FragHunter/DuePointVentilation/cad/heat-exchanger/review/HX-V1.1/05_room_end_plate_XY.png

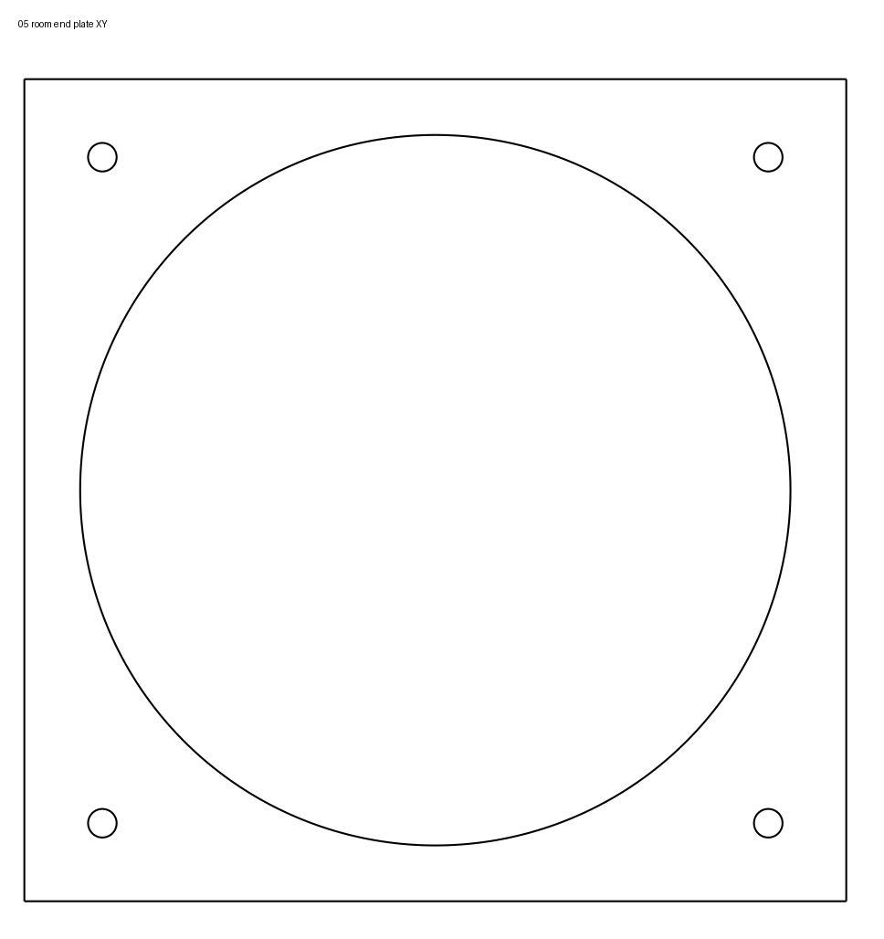
cad/heat-exchanger/review/HX-V1.1/05_room_end_plate_XY.png
