FragHunter/DuePointVentilation/cad/heat-exchanger/simulation/HX-V1.1/pressure-drop-sweep.png

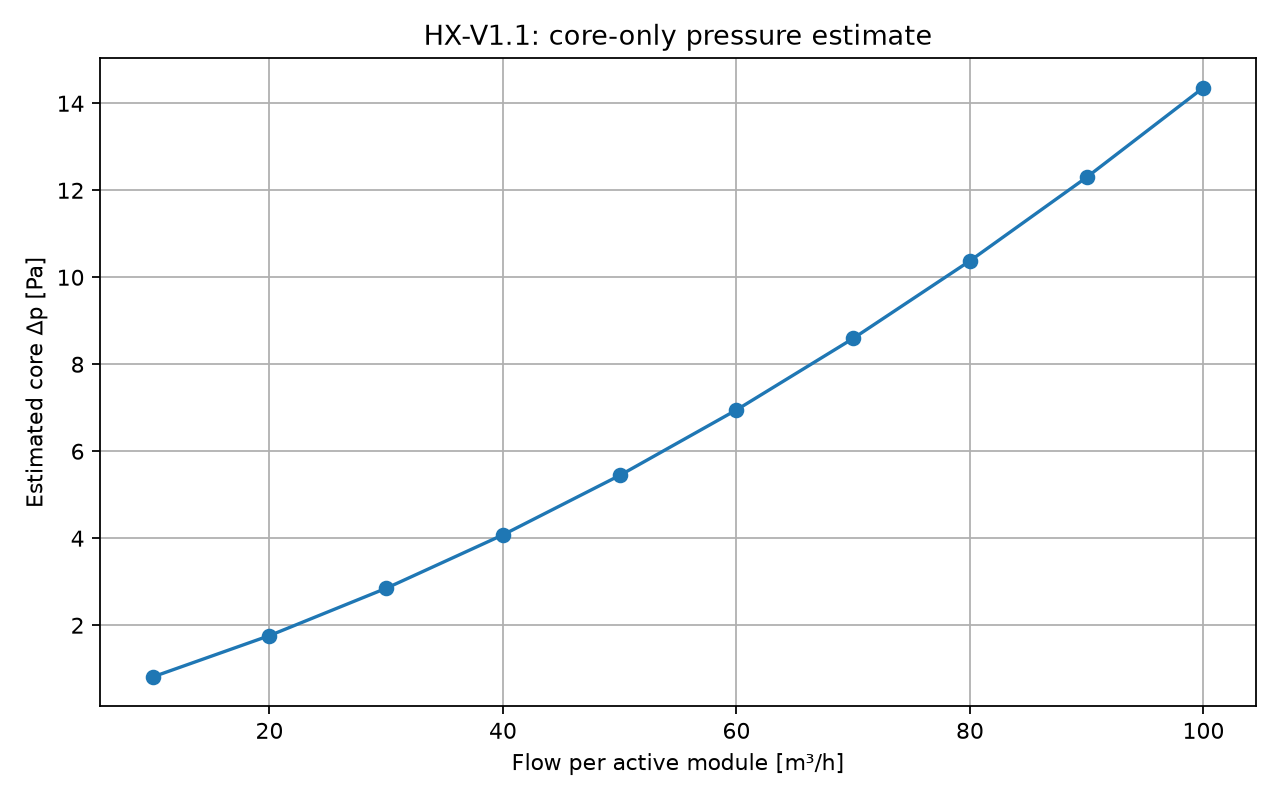
cad/heat-exchanger/simulation/HX-V1.1/pressure-drop-sweep.png
