FragHunter/DuePointVentilation/cad/heat-exchanger/simulation/HX-V1.1/solid-participation-sensitivity.png

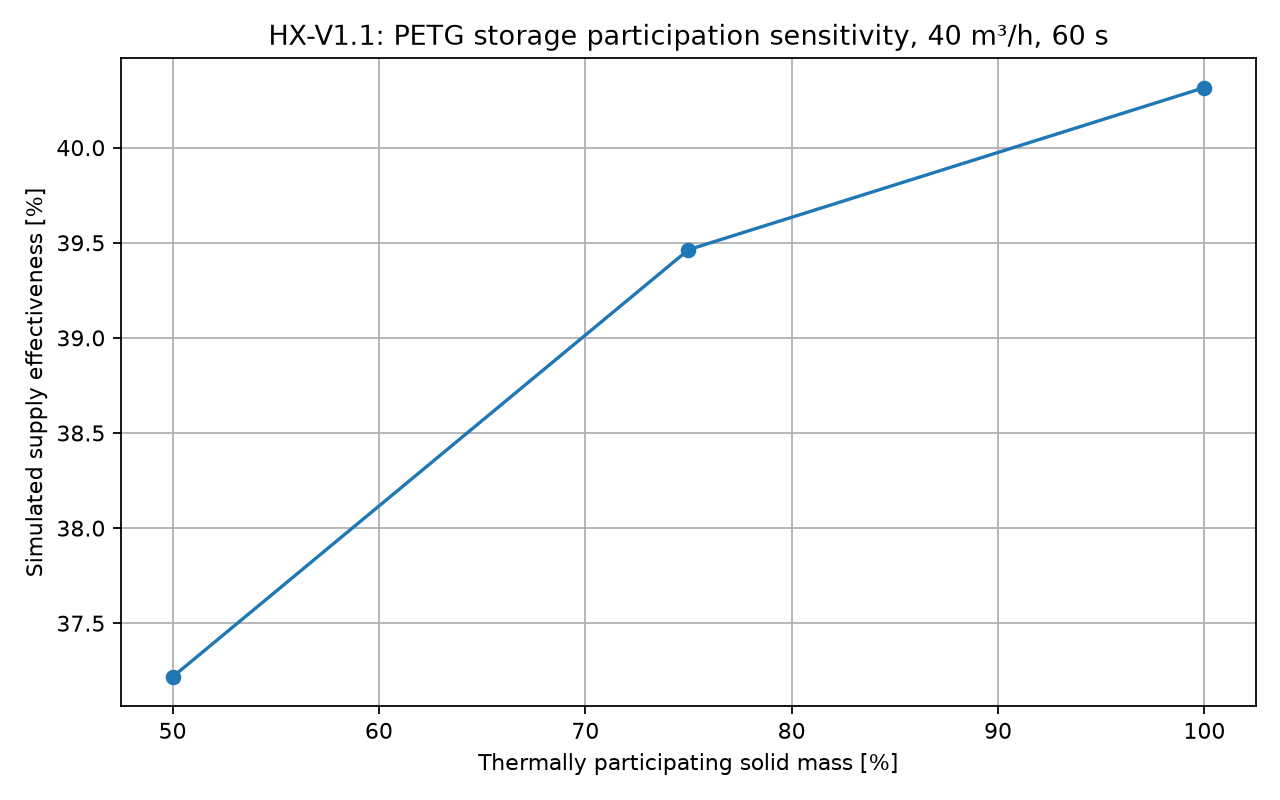
cad/heat-exchanger/simulation/HX-V1.1/solid-participation-sensitivity.png
