FragHunter/DuePointVentilation/cad/heat-exchanger/simulation/HX-V1.1/thermal-effectiveness-40m3h.png

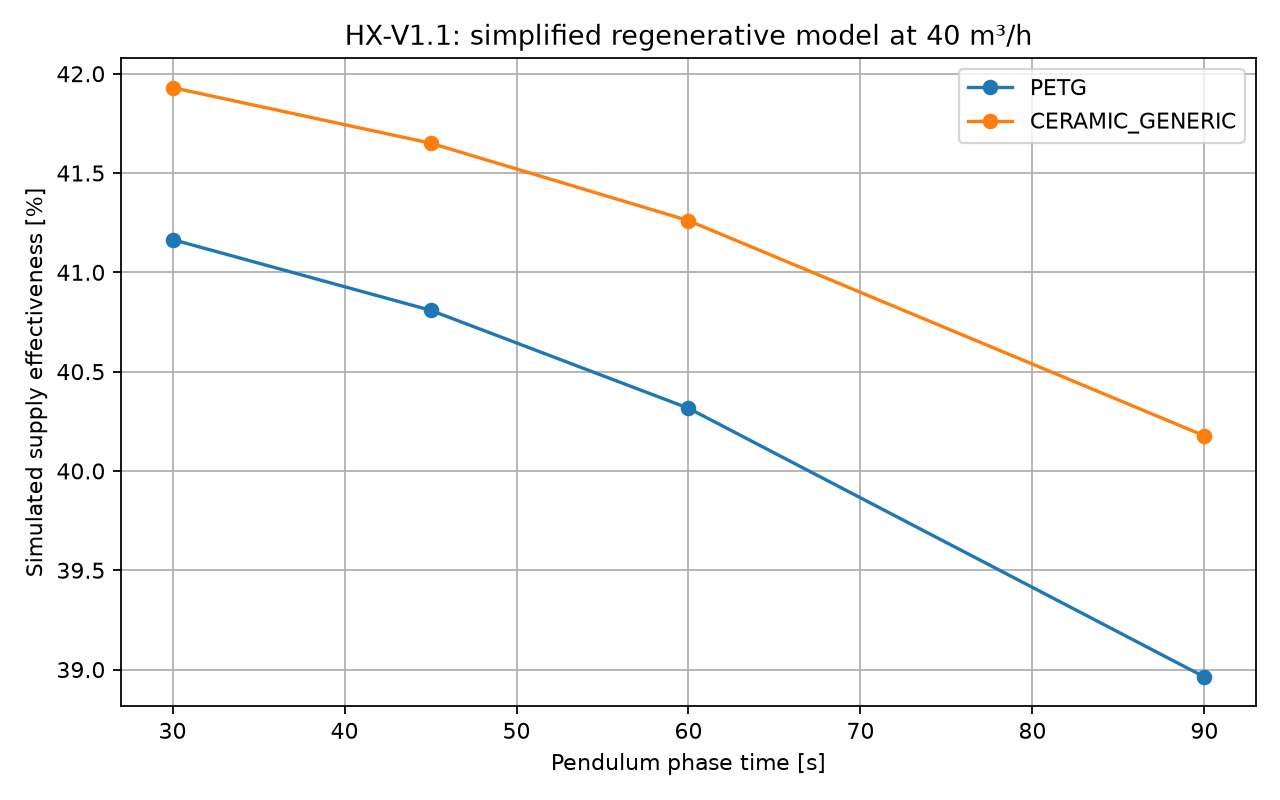
cad/heat-exchanger/simulation/HX-V1.1/thermal-effectiveness-40m3h.png
