FragHunter/DuePointVentilation/cad/heat-exchanger/exports/ROUTING-V0.3/ROUTING-V0.3-full-area-t-diverter-body.step

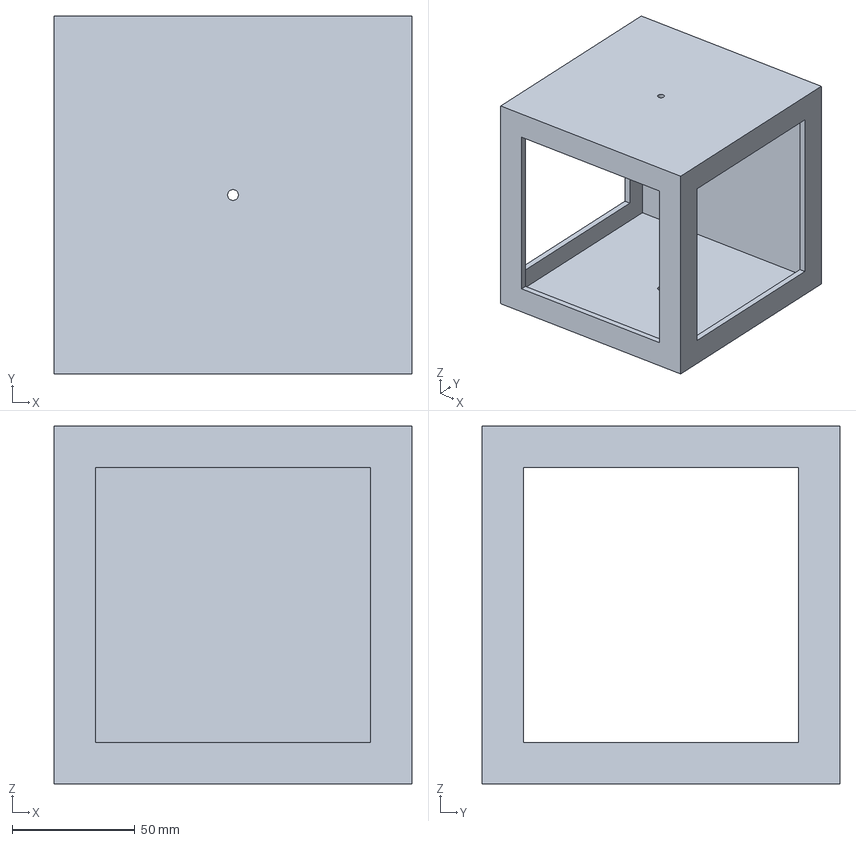
[picture p10: CAD file, 2026-09-27]
cad/heat-exchanger/exports/ROUTING-V0.3/ROUTING-V0.3-full-area-t-diverter-body.step
146.0 x 146.0 x 146.0 mm
