FragHunter/DuePointVentilation/cad/heat-exchanger/exports/HX-V1.1/HX-V1.1-assembly.step

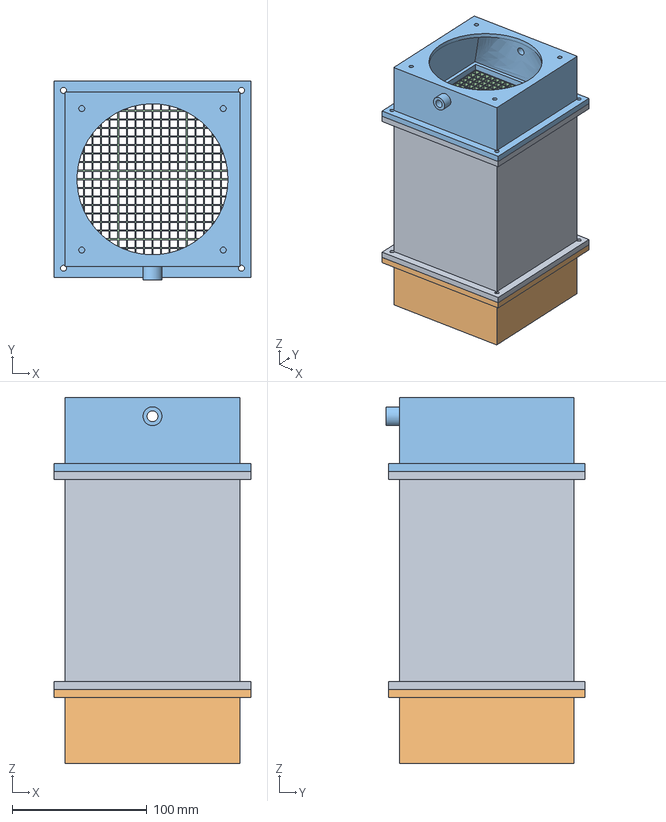
[picture p11: CAD file, 2026-09-27]
cad/heat-exchanger/exports/HX-V1.1/HX-V1.1-assembly.step
146.0 x 147.8 x 271.6 mm
