FragHunter/DuePointVentilation/cad/heat-exchanger/exports/HX-V1.1/HX-V1.1-fit-sleeve-ring.step

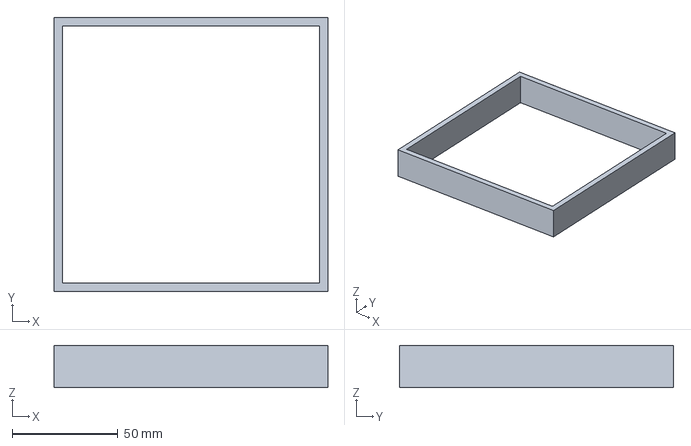
[picture p12: CAD file, 2026-09-27]
cad/heat-exchanger/exports/HX-V1.1/HX-V1.1-fit-sleeve-ring.step
129.6 x 129.6 x 20.0 mm
