FragHunter/DuePointVentilation/cad/heat-exchanger/exports/HX-V1.1/HX-V1.1-fit-core-plug.step

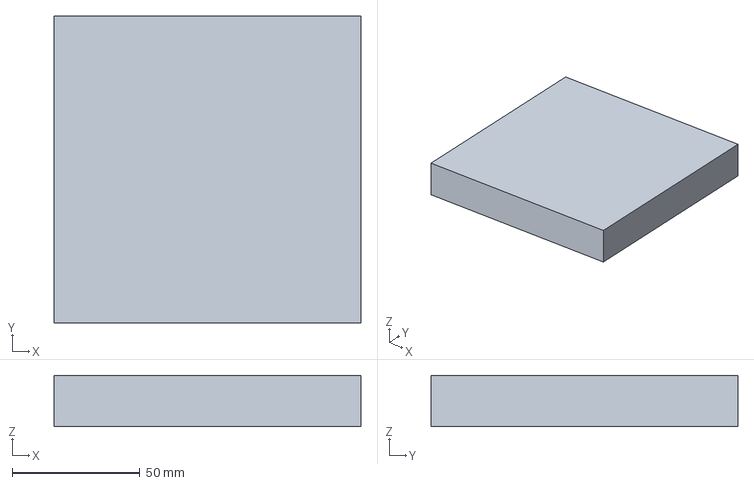
[picture p13: CAD file, 2026-09-27]
cad/heat-exchanger/exports/HX-V1.1/HX-V1.1-fit-core-plug.step
120.0 x 120.0 x 20.0 mm
