FragHunter/DuePointVentilation/cad/heat-exchanger/exports/ROUTING-V0.3/ROUTING-V0.3-t-diverter-flap-blank.step

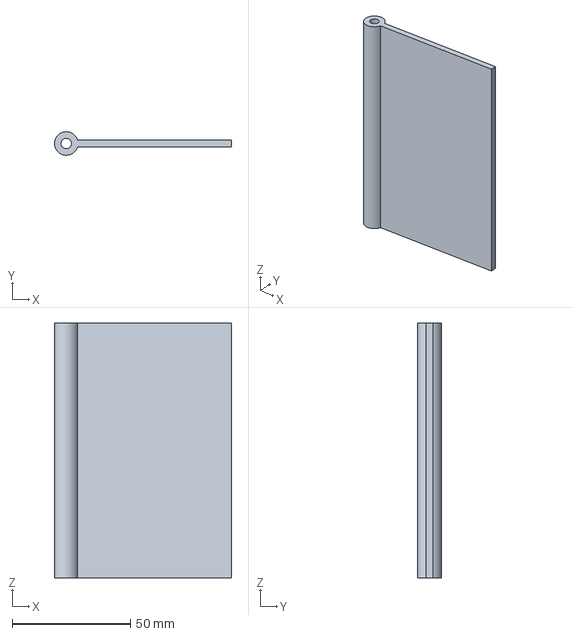
[picture p14: CAD file, 2026-09-27]
cad/heat-exchanger/exports/ROUTING-V0.3/ROUTING-V0.3-t-diverter-flap-blank.step
75.0 x 9.99 x 108.0 mm
