FragHunter/DuePointVentilation/cad/heat-exchanger/exports/HX-V1.1/HX-V1.1-fan-mount-gauge.step

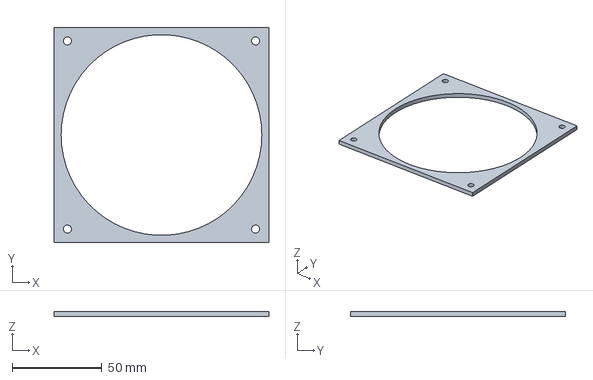
[picture p15: CAD file, 2026-09-27]
cad/heat-exchanger/exports/HX-V1.1/HX-V1.1-fan-mount-gauge.step
120.0 x 120.0 x 3.00 mm
