FragHunter/DuePointVentilation/cad/heat-exchanger/exports/ROUTING-V0.3/ROUTING-V0.3-exhaust-fan-square-transition.step

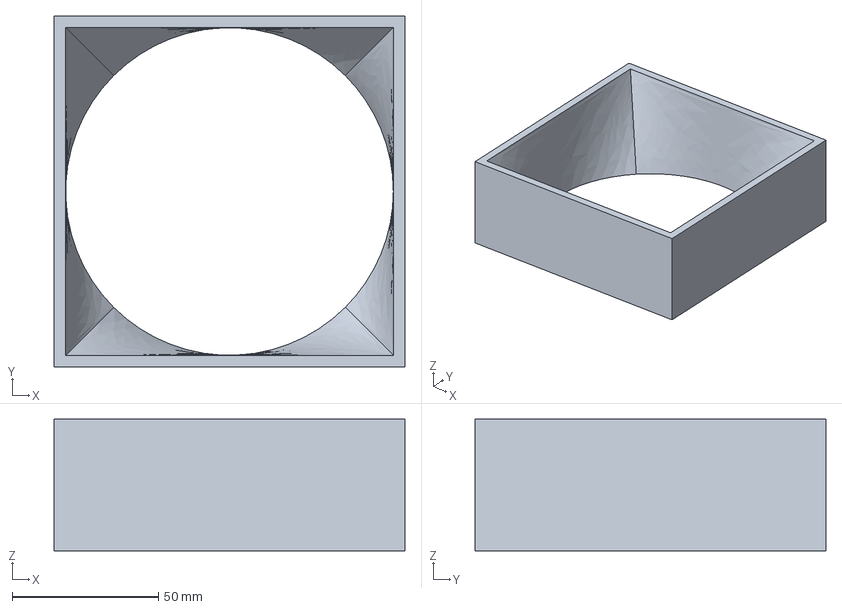
[picture p16: CAD file, 2026-09-27]
cad/heat-exchanger/exports/ROUTING-V0.3/ROUTING-V0.3-exhaust-fan-square-transition.step
120.0 x 120.0 x 45.0 mm
