FragHunter/DuePointVentilation/cad/heat-exchanger/exports/HX-V1.1/HX-V1.1-core-coupon.step

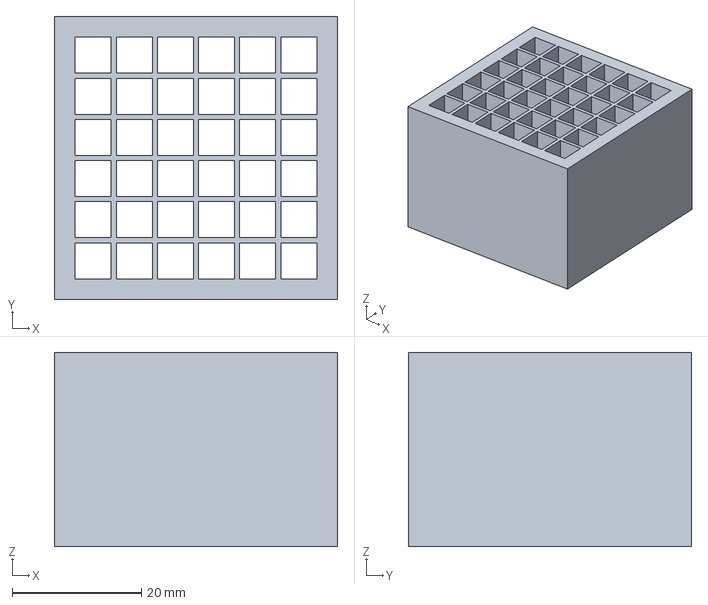
[picture p17: CAD file, 2026-09-27]
cad/heat-exchanger/exports/HX-V1.1/HX-V1.1-core-coupon.step
43.7 x 43.7 x 30.0 mm
