FragHunter/DuePointVentilation/cad/heat-exchanger/exports/HX-V1.1/HX-V1.1-outside-plenum.step

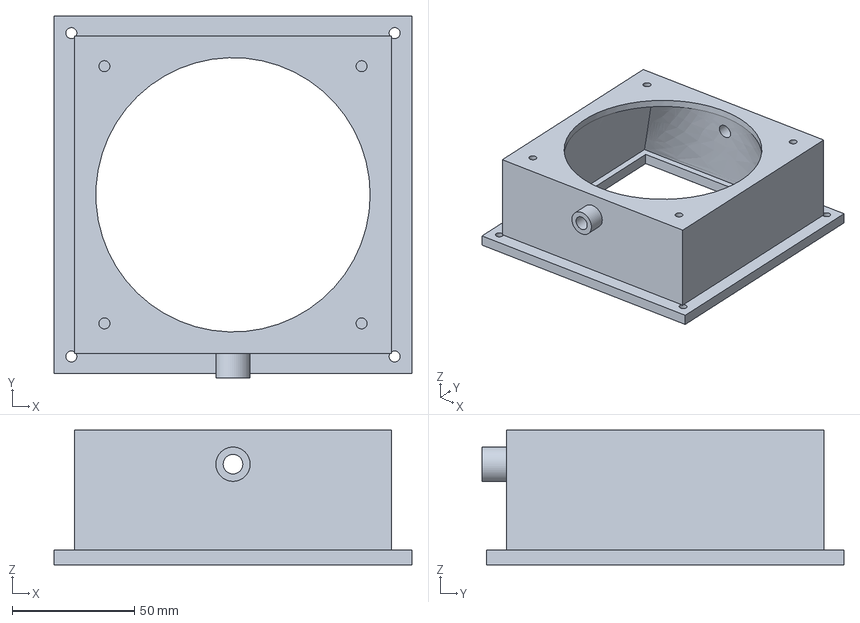
[picture p19: CAD file, 2026-09-27]
cad/heat-exchanger/exports/HX-V1.1/HX-V1.1-outside-plenum.step
146.0 x 147.8 x 55.0 mm
