FragHunter/DuePointVentilation/cad/heat-exchanger/exports/HX-V1.1/HX-V1.1-core-sleeve.step

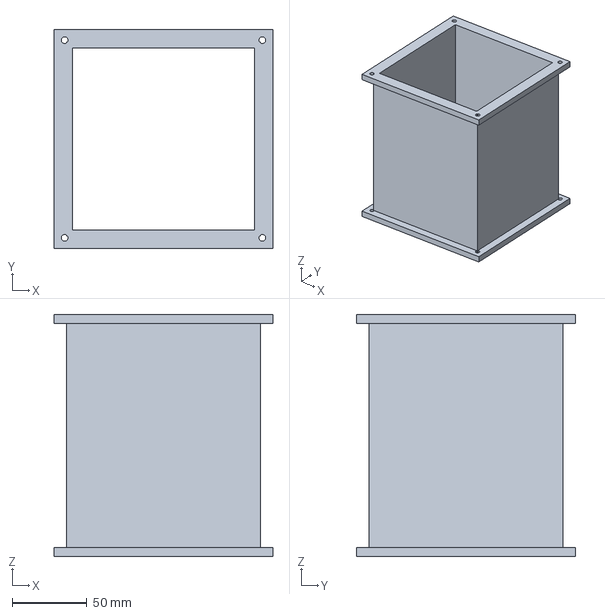
[picture p21: CAD file, 2026-09-27]
cad/heat-exchanger/exports/HX-V1.1/HX-V1.1-core-sleeve.step
146.0 x 146.0 x 161.6 mm
