FragHunter/DuePointVentilation/cad/heat-exchanger/exports/HX-V1/HX-V1-core.step

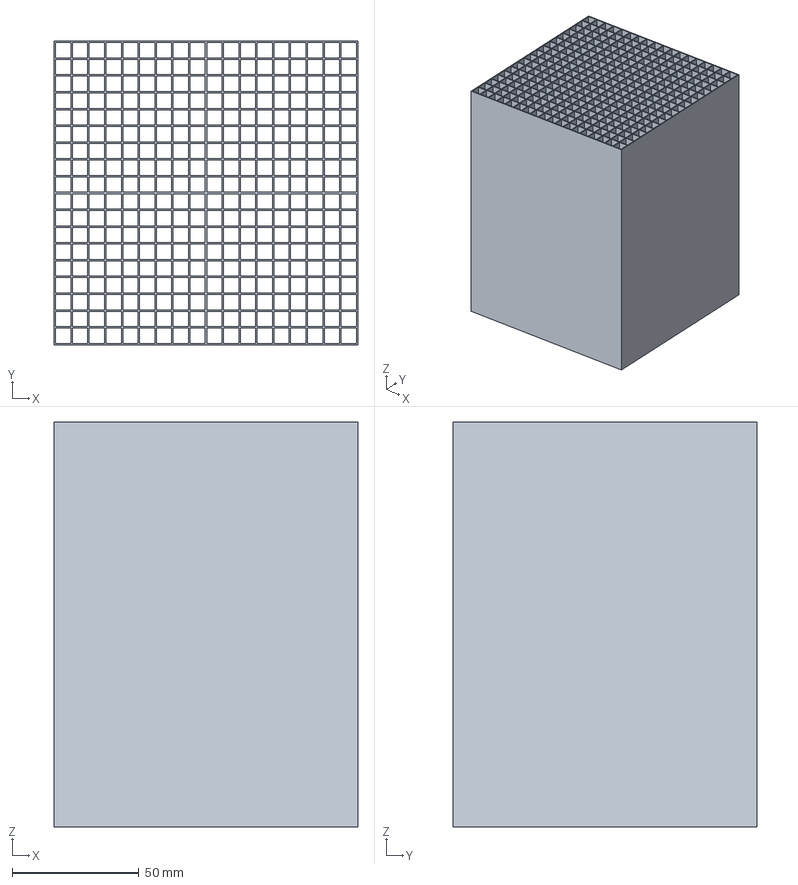
[picture p22: CAD file, 2026-09-27, an earlier design]
cad/heat-exchanger/exports/HX-V1/HX-V1-core.step
120.0 x 120.0 x 160.0 mm
