FragHunter/DuePointVentilation/cad/heat-exchanger/exports/ROUTING-V0.1/ROUTING-V0.1-servo-linkage-coupon.step

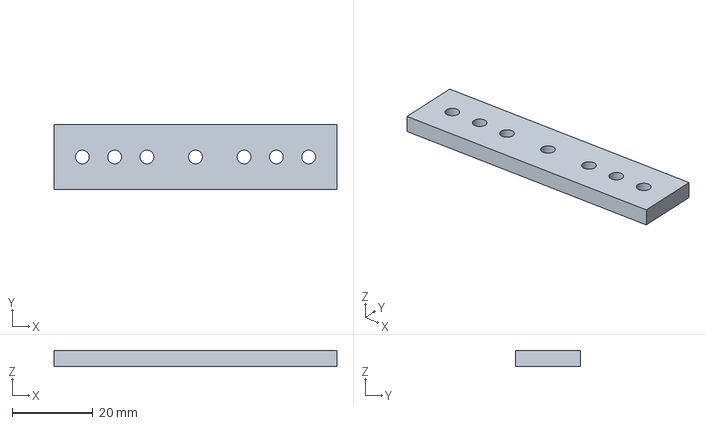
[picture p23: CAD file, 2026-09-27, an earlier design]
cad/heat-exchanger/exports/ROUTING-V0.1/ROUTING-V0.1-servo-linkage-coupon.step
70.0 x 16.0 x 4.00 mm
