FragHunter/DuePointVentilation/cad/heat-exchanger/exports/ROUTING-V0.2/ROUTING-V0.2-diverter-flap-blank.step

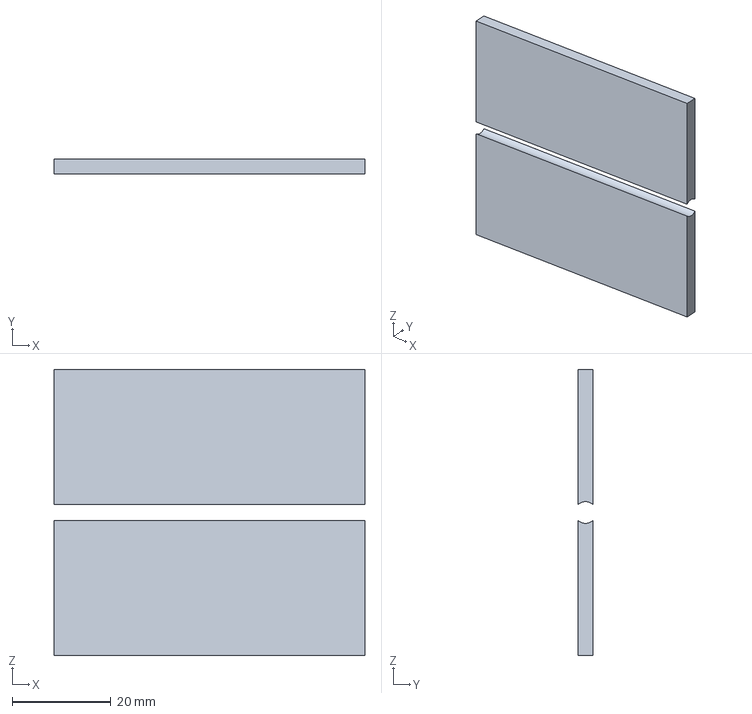
[picture p24: CAD file, 2026-09-27, an earlier design]
cad/heat-exchanger/exports/ROUTING-V0.2/ROUTING-V0.2-diverter-flap-blank.step
63.0 x 3.00 x 58.0 mm
