FragHunter/DuePointVentilation/cad/heat-exchanger/exports/HX-V1/HX-V1-module-shell.step

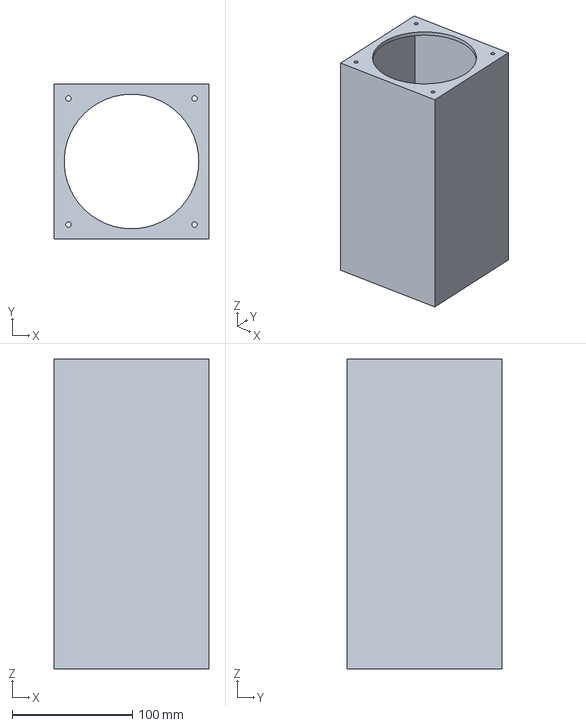
[picture p25: CAD file, 2026-09-27, an earlier design]
cad/heat-exchanger/exports/HX-V1/HX-V1-module-shell.step
128.8 x 128.8 x 258.0 mm
