FragHunter/DuePointVentilation/cad/heat-exchanger/exports/ROUTING-V0.1/ROUTING-V0.1-seal-gap-coupon.step

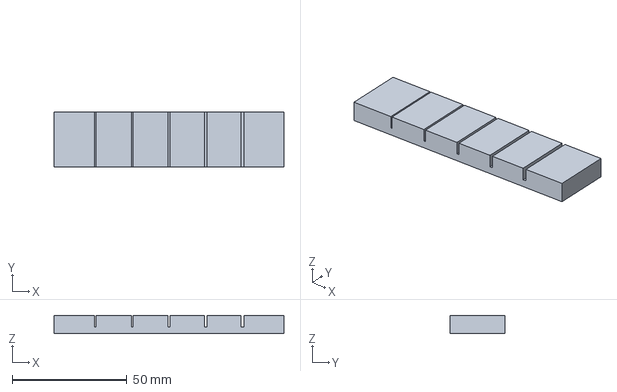
[picture p26: CAD file, 2026-09-27, an earlier design]
cad/heat-exchanger/exports/ROUTING-V0.1/ROUTING-V0.1-seal-gap-coupon.step
100.0 x 24.0 x 8.00 mm
