FragHunter/DuePointVentilation/(list of files, cad)

Other CAD files:
cad/heat-exchanger/exports/HX-V1.1/HX-V1.1-room-plenum.step
cad/heat-exchanger/exports/HX-V1.1/HX-V1.1-assembly.stl
cad/heat-exchanger/exports/HX-V1.1/HX-V1.1-core-coupon.stl
cad/heat-exchanger/exports/HX-V1.1/HX-V1.1-core-sleeve.stl
cad/heat-exchanger/exports/HX-V1.1/HX-V1.1-core.stl
cad/heat-exchanger/exports/HX-V1.1/HX-V1.1-fan-mount-gauge.stl
cad/heat-exchanger/exports/HX-V1.1/HX-V1.1-fit-core-plug.stl
cad/heat-exchanger/exports/HX-V1.1/HX-V1.1-fit-sleeve-ring.stl
cad/heat-exchanger/exports/HX-V1.1/HX-V1.1-gasket.stl
cad/heat-exchanger/exports/HX-V1.1/HX-V1.1-outside-plenum.stl
cad/heat-exchanger/exports/HX-V1.1/HX-V1.1-room-plenum.stl
cad/heat-exchanger/exports/HX-V1/HX-V1-core.stl
cad/heat-exchanger/exports/HX-V1/HX-V1-module-shell.stl
cad/heat-exchanger/exports/ROUTING-V0.1/ROUTING-V0.1-core-routing-adapter.step
cad/heat-exchanger/exports/ROUTING-V0.1/ROUTING-V0.1-core-routing-adapter.stl
cad/heat-exchanger/exports/ROUTING-V0.1/ROUTING-V0.1-p12-fan-pod.step
cad/heat-exchanger/exports/ROUTING-V0.1/ROUTING-V0.1-p12-fan-pod.stl
cad/heat-exchanger/exports/ROUTING-V0.1/ROUTING-V0.1-seal-gap-coupon.stl
cad/heat-exchanger/exports/ROUTING-V0.1/ROUTING-V0.1-servo-linkage-coupon.stl
cad/heat-exchanger/exports/ROUTING-V0.1/ROUTING-V0.1-shaft-clearance-coupon.step
cad/heat-exchanger/exports/ROUTING-V0.1/ROUTING-V0.1-shaft-clearance-coupon.stl
cad/heat-exchanger/exports/ROUTING-V0.2/ROUTING-V0.2-diverter-flap-blank.stl
cad/heat-exchanger/exports/ROUTING-V0.2/ROUTING-V0.2-double-diverter-body.step
cad/heat-exchanger/exports/ROUTING-V0.2/ROUTING-V0.2-double-diverter-body.stl
cad/heat-exchanger/exports/ROUTING-V0.2/ROUTING-V0.2-fan-rect-transition.step
cad/heat-exchanger/exports/ROUTING-V0.2/ROUTING-V0.2-fan-rect-transition.stl
cad/heat-exchanger/exports/ROUTING-V0.2/ROUTING-V0.2-supply-merge-collector.step
cad/heat-exchanger/exports/ROUTING-V0.2/ROUTING-V0.2-supply-merge-collector.stl
cad/heat-exchanger/exports/ROUTING-V0.3/ROUTING-V0.3-exhaust-fan-square-transition.stl
cad/heat-exchanger/exports/ROUTING-V0.3/ROUTING-V0.3-full-area-t-diverter-body.stl
cad/heat-exchanger/exports/ROUTING-V0.3/ROUTING-V0.3-t-diverter-flap-blank.stl
