FragHunter/DuePointVentilation/cad/heat-exchanger/review/HX-V1.1/02_assembly_XY_core_mid.png

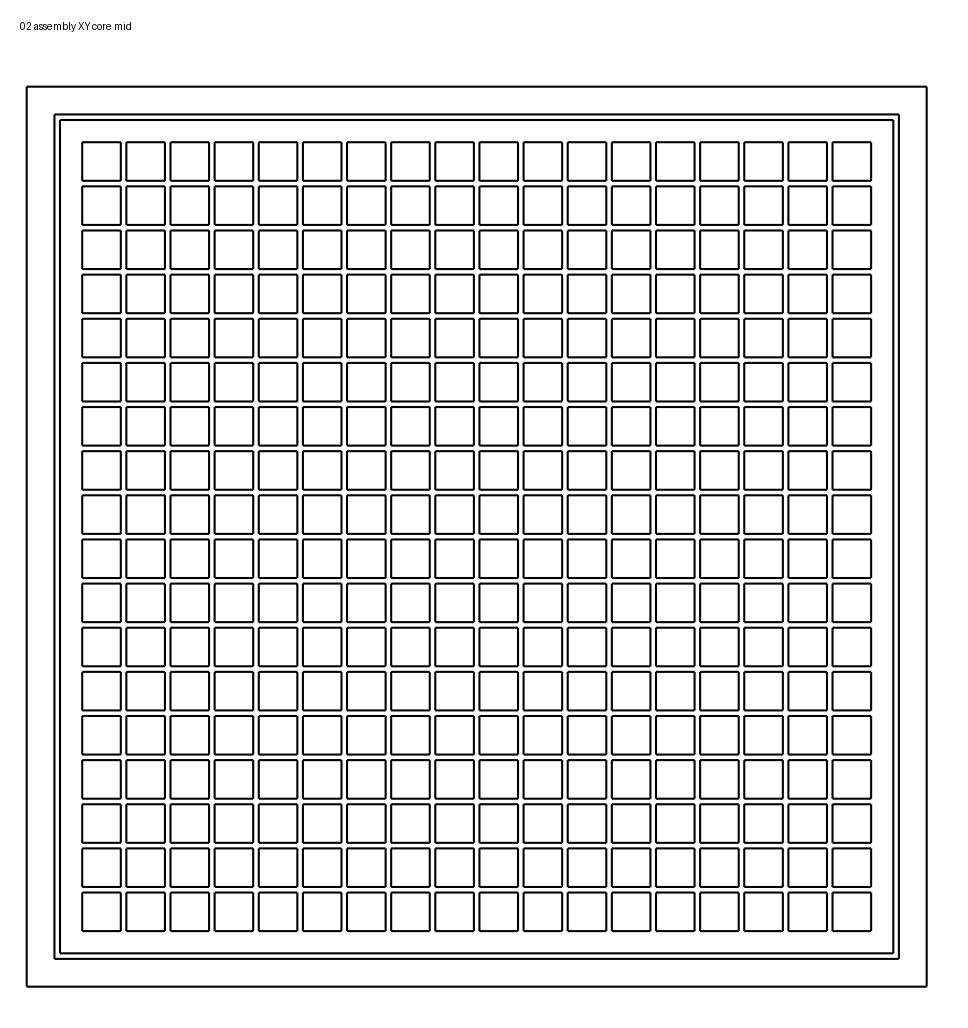
cad/heat-exchanger/review/HX-V1.1/02_assembly_XY_core_mid.png
