FragHunter/DuePointVentilation/cad/heat-exchanger/review/HX-V1.1/03_assembly_XZ_center.png

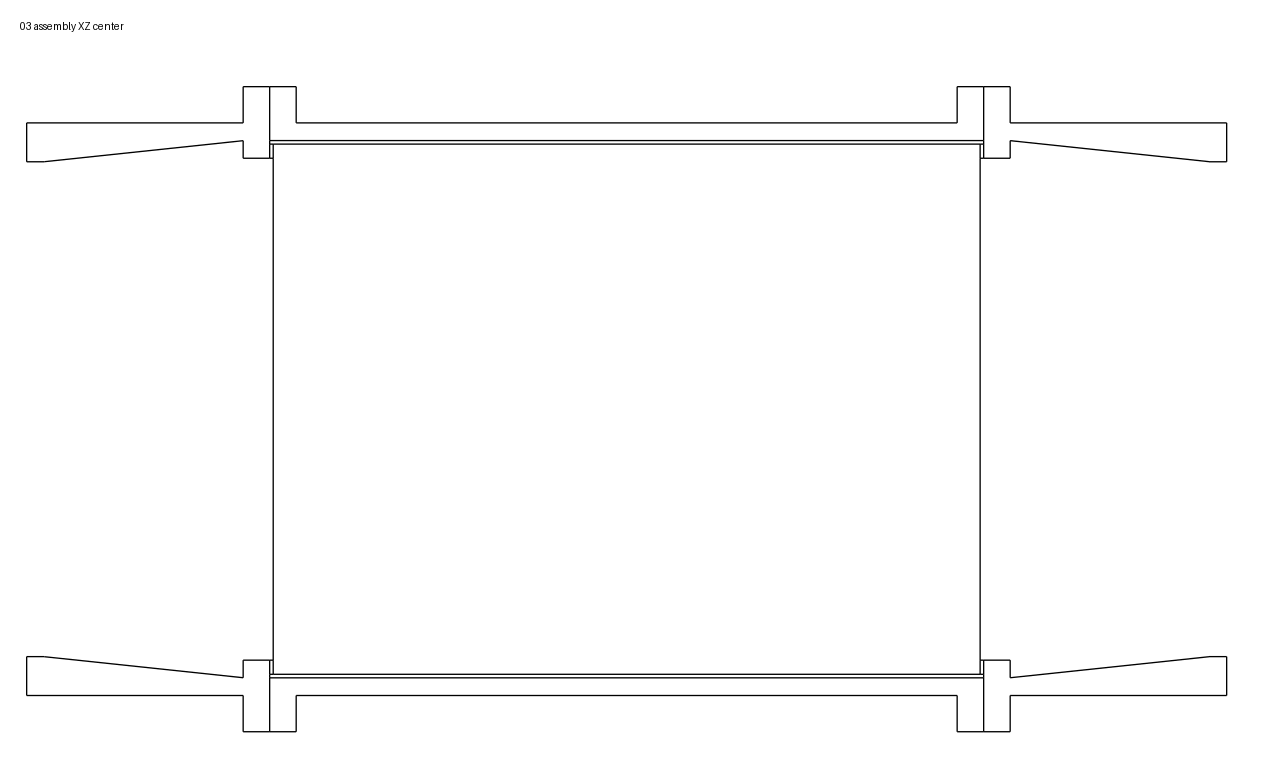
cad/heat-exchanger/review/HX-V1.1/03_assembly_XZ_center.png
