FragHunter/DuePointVentilation/cad/heat-exchanger/review/HX-V1.1/04_assembly_YZ_center.png

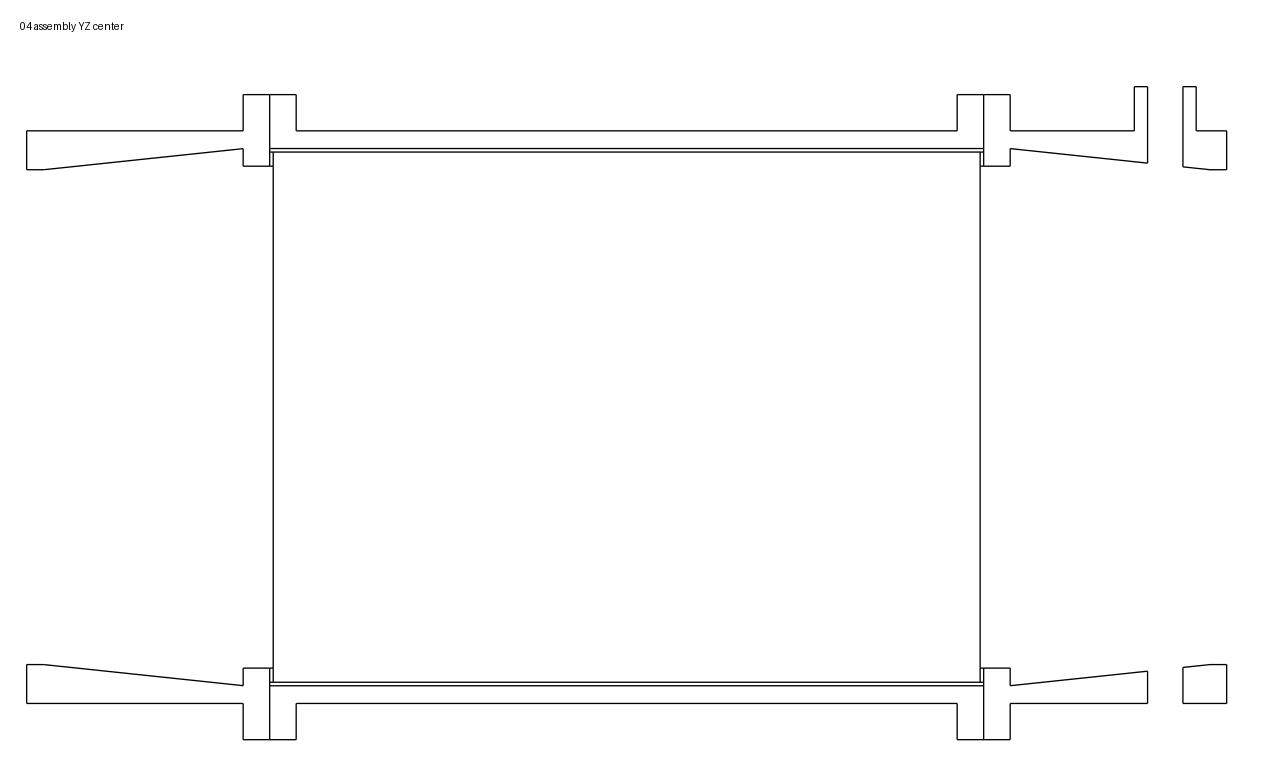
cad/heat-exchanger/review/HX-V1.1/04_assembly_YZ_center.png
