FragHunter/DuePointVentilation/cad/heat-exchanger/test-data/templates/routing-v0.1-airflow.csv

test_id | date_utc | configuration | route | supply_pwm_pct | exhaust_pwm_pct | supply_fan_count | exhaust_fan_count | supply_airflow_m3h | exhaust_airflow_m3h | supply_delta_p_pa | exhaust_delta_p_pa | leakage_flow_m3h | isolated_lane_pressure_pa | sound_db | fan_rpm_1 | fan_rpm_2 | fan_rpm_3 | servo_position | notes
example
