FragHunter/DuePointVentilation/(commit log)

2026-09-27 docs: define Aqara T1 Zigbee sensor integration
2026-09-27 docs: add Zigbee sensor alternatives
2026-09-27 docs: add 3D-printed heat exchanger design plan
2026-09-27 docs: add heat exchanger milestone and Aqara decision
2026-09-27 docs: integrate printed heat exchanger into architecture
2026-09-27 cad: add parametric HX-V1 heat exchanger core
2026-09-27 cad: pivot HX-V1 to regenerative pendulum matrix
2026-09-27 cad: add first opposed-fan pendulum module shell
2026-09-27 cad: publish HX-V1 STEP and STL exports
    [HX-V1-core.step, HX-V1-core.stl, HX-V1-module-shell.step, HX-V1-module-shell.stl]
2026-09-27 cad: implement HX-V1.1 serviceable Mega S prototype
    [HX-V1.1-assembly.step, HX-V1.1-assembly.stl, HX-V1.1-core-sleeve.step, HX-V1.1-core-sleeve.stl, HX-V1.1-core.step, HX-V1.1-core.stl, HX-V1.1-gasket.step, HX-V1.1-gasket.stl]
2026-09-27 cad: add Mega S core calibration coupon
    [HX-V1.1-core-coupon.step, HX-V1.1-core-coupon.stl]
2026-09-27 test: add Mega S fit gauges and bench data pipeline
    [HX-V1.1-fan-mount-gauge.step, HX-V1.1-fan-mount-gauge.stl, HX-V1.1-fit-core-plug.step, HX-V1.1-fit-core-plug.stl, HX-V1.1-fit-sleeve-ring.step, HX-V1.1-fit-sleeve-ring.stl, hx-v1.1-bench.csv]
2026-09-27 CAD: define servo-routed 2+1 manifold architecture
2026-09-27 CAD: scaffold servo-routing manifold work
2026-09-27 CAD: add ROUTING-V0.1 servo manifold validation parts
    [ROUTING-V0.1-core-routing-adapter.step, ROUTING-V0.1-core-routing-adapter.stl, ROUTING-V0.1-p12-fan-pod.step, ROUTING-V0.1-p12-fan-pod.stl, ROUTING-V0.1-seal-gap-coupon.step, ROUTING-V0.1-seal-gap-coupon.stl, ROUTING-V0.1-servo-linkage-coupon.step, ROUTING-V0.1-servo-linkage-coupon.stl]
2026-09-27 Docs: add ROUTING-V0.1 bench measurement protocol
    [routing-v0.1-airflow.csv, routing-v0.1-coupon-servo.csv]
2026-09-27 CAD: add ROUTING-V0.2 collector and diverter prototype
    [ROUTING-V0.2-diverter-flap-blank.step, ROUTING-V0.2-diverter-flap-blank.stl, ROUTING-V0.2-double-diverter-body.step, ROUTING-V0.2-double-diverter-body.stl, ROUTING-V0.2-fan-rect-transition.step, ROUTING-V0.2-fan-rect-transition.stl, ROUTING-V0.2-supply-merge-collector.step, ROUTING-V0.2-supply-merge-collector.stl]
2026-09-27 CAD: replace constricted diverter with full-area V0.3
    [ROUTING-V0.3-exhaust-fan-square-transition.step, ROUTING-V0.3-exhaust-fan-square-transition.stl, ROUTING-V0.3-full-area-t-diverter-body.step, ROUTING-V0.3-full-area-t-diverter-body.stl, ROUTING-V0.3-t-diverter-flap-blank.step, ROUTING-V0.3-t-diverter-flap-blank.stl, routing-v0.3-t-diverter.csv]
